sartajChowdhury/EECS452MDE/README.txt

TEAM MEMBERS:
Adam Karaien - akaraien@umich.edu	
Jesse Hu - jessehu@umich.edu
Megi Shahollari - mshaholl@umich.edu
Ross Richards - rossrish@umich.edu
Sartaj Chowdhury - sartajc@umich.edu

ZIP FILE CONTENTS:
video folder (contains demo footage)
src folder (contains OVERVIEW.txt, USAGE.txt)
design folder (contains part list)
data folder (contains plots)
README.txt
COPYRIGHT.txt
2024-Team-7-poster.pdf
2024-Team-7-final.pdf
