sartajChowdhury/EECS452MDE/2024-Team-7-poster.pdf

# Mobile ECG Measurement

Sartaj Chowdhury, Jesse Hu, Adam Karaien, Ross Richards, Megi Shahollari {sartajc, jessehu, akaraien, rossrich, mshaholl}@umich.edu

## EECS 452 - Winter 2024 Digital Signal Processing

## Introduction: Collecting Heart Rate Signal From Electrodes

## Signal Processing Techniques: Removing Noise From ECG Signal

- Electrocardiogram (ECG) is a recording of electrical activity from the heart
- Three sets of electrode leads capture ECG signals
- ECG signals require processing to extract useful information from them

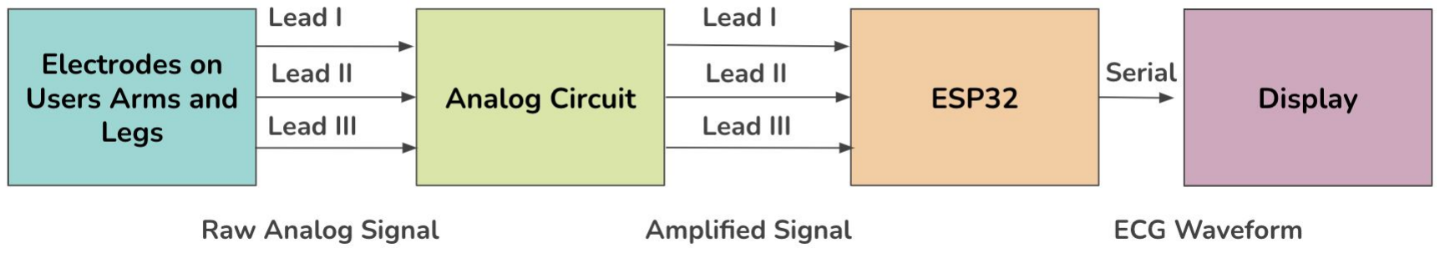
[picture p4: figure]

## Implementation: 3-Lead ECG with Analog Circuit and ESP-32

•Remove Baseline Wander:

- 0.5-150 Hz Bandpass Filter •Software Filter:
- 60 Hz Notch Filter
- Peak Detection:
- Pan-Tompkins Algorithm
- Real-time Plotting:
- Serial Communication -> Python Script

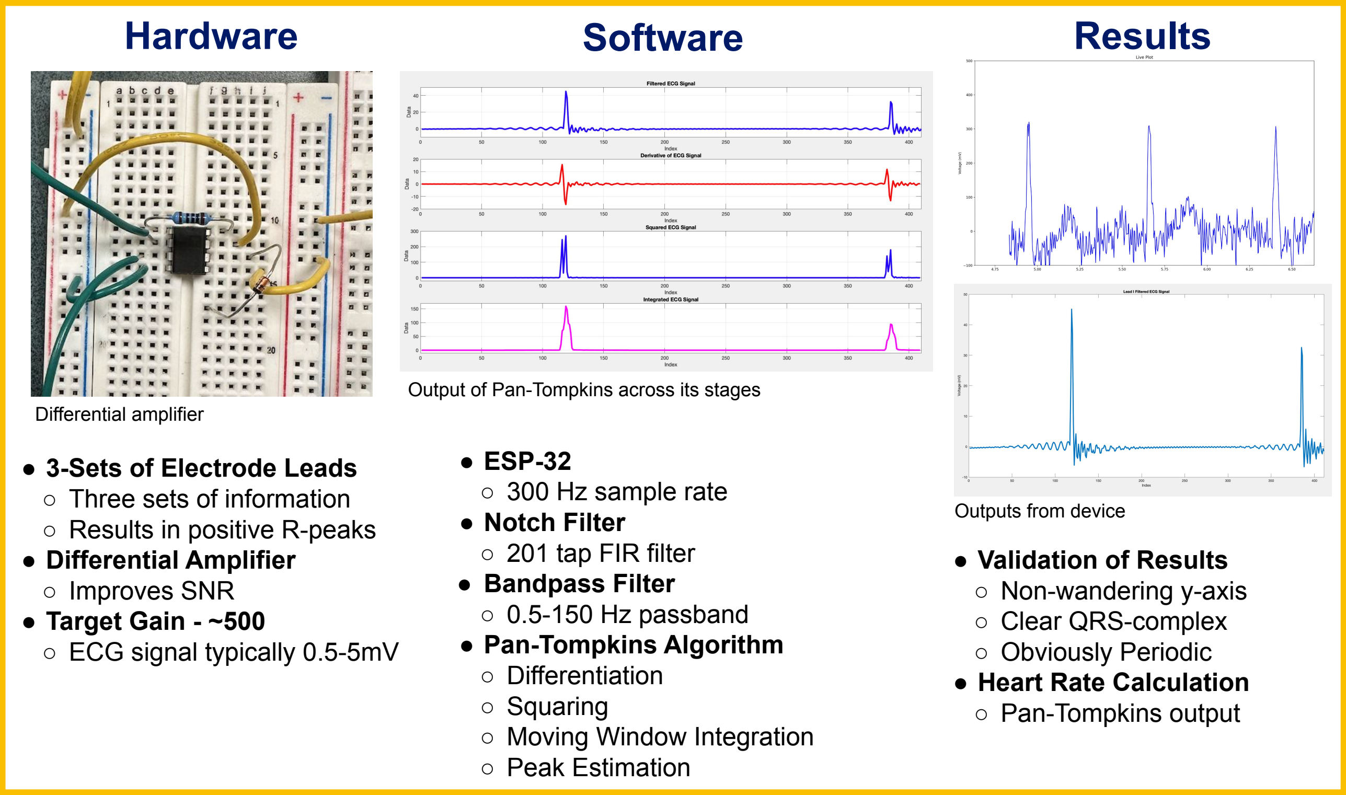
[picture p5: figure]
Hardware; Software; ● Validation of Results ○ Non-wandering y-axis ○ Clear QRS-complex ○ Obviously Periodic ● Heart Rate Calculation ○ Pan-Tompkins output; ● ESP-32 ○ 300 Hz sample rate ● Notch Filter ○ 201 tap FIR filter ● Bandpass Filter ○ 0.5-150 Hz passband ● Pan-Tompkins Algorithm ○ Differentiation ○ Squaring ○ Moving Window Integration ○ Peak Estimation; ● 3-Sets of Electrode Leads ○ Three sets of information ○ Results in positive R-peaks ● Differential Amplifier ○ Improves SNR ● Target Gain - ~500 ○ ECG signal typically 0.5-5mV; Results; Differential amplifier; Outputs from device

Acknowledgements: Special thanks to Dr. Shai Revzen and Audrey Cooke

Output of Pan-Tompkins across its stages
