sartajChowdhury/EECS452MDE/data/bodeBP.png

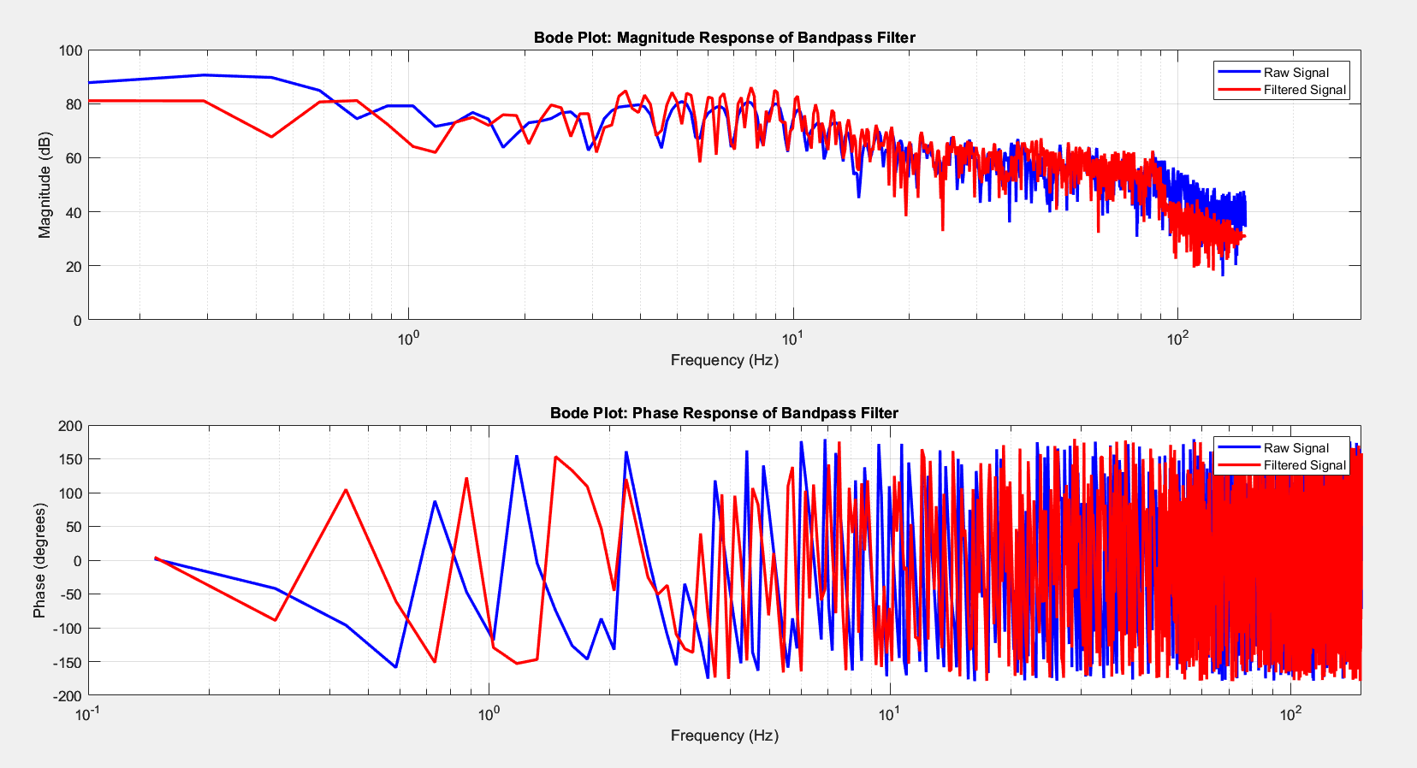
data/bodeBP.png
