sartajChowdhury/EECS452MDE/data/FIR_Notch_Filter_Bode_Plot.png

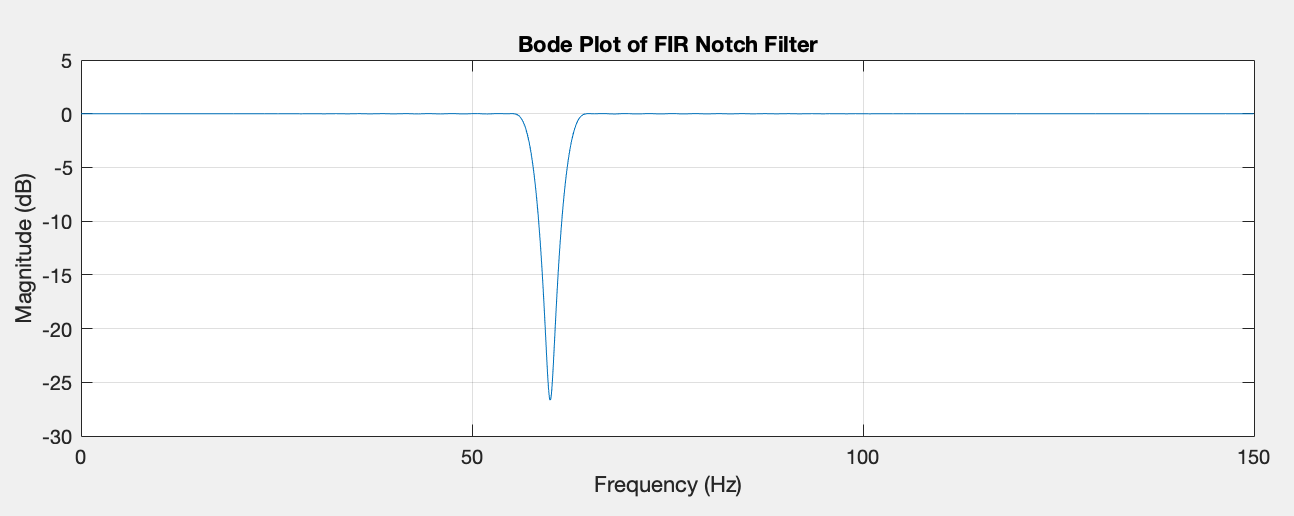
data/FIR_Notch_Filter_Bode_Plot.png
