sartajChowdhury/EECS452MDE/design/Parts_List.pdf

### EECS 452 Group

### 7 Parts List

P a r t N u m b e r | D e s c r i p t i o n | O r d e r i n g U R L | Q t y | P r i c e
B 0 8 2 P 9 N L 5 9 | 4 0 P a c k o f E l e c t r o d e s | h t t p s:// w w w.a m a z o n.c o m / K S -P r e miu m -Ele c t r o d e -R e u s a ble -Ele c t r o d e s / d p / B 0 8 2 P 9 N L 5 9 / r e f = s r_ 1 _ 1 ? c rid = 3 G 5 O F L 4 T W N 4 Z N & k e y w o r d s = ele c t r o d e & qid = 1 7 0 7 4 4 1 5 3 3 & s p r e fix = el (https://www.amazon.com/KS-Premium-Electrode-Reusable-Electrodes/dp/B082P9NL59) ectrode%2Caps%2C257&sr= 8-1 | 1 | $ 1 6.9 9
2 0 5 0 | L C D S c r e e n | h t t p s:// w w w.a d a f r uit.c o m / p r o d u c t / 2 0 5 0 ? g a d _ s o u r c e = 1 & g cli (https://www.adafruit.com/product/2050?gad_source=1) d=EAIaIQobChMI0aWKy93Z hAMVV19HAR2D8g_3EAQY BiABEgJvAfD_BwE | 1 | $ 3 9.9 5
E L -C K -0 0 4 | R e s i s t o r K i t | h t t p s:// w w w.a m a z o n.c o m / Ele g o o -Valu e s -R e sis t o r -A s s o r t m e n t -C o m plia n t / d p / B 0 7 2 B L 2 V X 1 / r e f = s r_ 1 _ 2 _ s s p a ? c rid = 1 L 6 8 N B G O 8 W 0 V M & k e y w o r d s = r e sis t o r + kit & qid = 1 7 0 7 4 4 1 7 2 9 & s p r e fix = r e sis t o r + kit % 2 C a p s % 2 C 1 2 2 & s r = 8 -2 -s p o n s & s p _ c s d = d 2lk Z 2 V 0 T m F t Z T 1 z c F 9 h d G Y & p s c = 1 (https://www.amazon.com/Elegoo-Values-Resistor-Assortment-Compliant/dp/B072BL2VX1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) | 1 | $ 7.9 9
B 0 C 1 V 8 Q 9 3 P | C ap a c i t o r K i t | h t t p s:// w w w.a m a z o n.c o m /A L L E CIN -M o n olit hic -C e r a mic -C a p a cit o r -Kit / d p / B 0 C 1 V 8 Q 9 3 P / r e f = s r_ 1 _ 2 _ s s p a ? c rid = 3 4 1 X Y S 8 T J 8 Q 8 2 & k e y w o r d s = c a p a ci (https://www.amazon.com/ALLECIN-Monolithic-Ceramic-Capacitor-Kit/dp/B0C1V8Q93P?sp_csd=d2lkZ2V0TmFtZT1zcF9hdGY) tor+kit&qid=1707441923&spr efix=capacitor+kit%2Caps%2 C124&sr=8-2-spons&sp_csd =d2lkZ2V0TmFtZT1zcF9hdG Y&psc=1 | 1 | $ 9.9 9
E L -C P -0 0 3 | B r e a d B o a r d | h t t p s:// w w w.a m a z o n.c o m / E L -C P -0 0 3 -B r e a d b o a r d -S old e rle (https://www.amazon.com/EL-CP-003-Breadboard-Solderless-Distribution-Connecting/dp/B01EV6LJ7G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) | 1 | $ 9.9 9

| | s s -Dis t rib u tio n -C o n n e c tin g / d p / B 0 1 E V 6 L J 7 G / r e f = s r_ 1 _ 1 _ s s p a ? c rid = 2 3 P G E T J H GI3 6 4 & k e y w o r d s = b r e a d b o a r d & qid = 1 7 0 7 4 4 1 5 7 4 & s p r e fix = b r e a d b o a r d % 2 C a p s % 2 C 1 3 8 & s r = 8 -1 -s p o n s & s p _ c s d = d 2lk Z 2 V 0 T m F t Z T 1 z c F 9 h d G Y & t h = 1 (https://www.amazon.com/EL-CP-003-Breadboard-Solderless-Distribution-Connecting/dp/B01EV6LJ7G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)
1 1 5 1 7 4 | I n s t ru m e n t a t i o n A m p A D 6 2 0 | h t t p s:// w w w.j a m e c o.c o m / z /A D 6 2 0 A N -A n alo g -D e vic e s -IC -A D 6 2 0 A N -L o w -C o s t -L o w -P o w e r -In s t r u m e n t -A m p -1 8 V-6 5 0 m W_ 1 1 5 1 7 4.h t ml? CID = G O O G & g a d _ s o u r c e = 4 & g clid = Cj w K C AiAlc y u B h B n Eiw A O G Z 2 S 7 c g d HiL B U a 5 N N a 1 8 d s A b M L 1 U Q A f 3 miW x 3 P g -glD 4 Y 9 m Z AA W J v_ 2 b h o C Z S M Q Av D _ B w E (https://www.analog.com/en/products/ad620.html) | 8 | $ 1 5.0 0
5 9 5 -U A 7 4 1 C P | O p -A m p | h t t p s:// w w w.m o u s e r.c o m / P r o d u c t D e t ail/ Te x a s -In s t r u m e n t s / U A 7 4 1 C P ? q s = W z g T T 8 0 q u P H F 8 v T 6 3 U V w 5 w % 3 D % 3 D & m g h = 1 & g a d _ s o u r c e = 4 & g clid = Cj w K C AiAlJ K u B h A d Eiw A n Z b 7lT f N r k_ G 9 o 3lQ -p c Z 5 z o S S g 5lX C 5 E q G 5 O kl9 r 9 a 6Iu 6 p D s t 3 d Z z h G x o C 6 b 8 Q Av D _ B w E (https://www.mouser.com/ProductDetail/Texas-Instruments/UA741CP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) | 4 | $ 0.4 9
A D 8 2 3 2 A C P Z -R 7 | E C G B a c kup C h i p | h t t p s:// w w w.digik e y.c o m / e n / p -i (https://www.digikey.com/en/products/detail/analog-devices-inc./AD8232ACPZ-R7/3758424?gad_source=1) nc./AD8232ACPZ-R7/375842 4?utm_adgroup=&utm_sourc e=google&utm_medium=cpc &utm_campaign=PMax%20S hopping_Product_Medium%2 0ROAS%20Categories&utm_ term=&utm_content=&utm_id =go_cmp-20223376311_adg- _ad-__dev-c_ext-_prd-37584 24_sig-Cj0KCQiA5rGuBhCnA RIsAN11vgTm-kWJWhaUuNii r o d u c t s / d e t ail/ a n alo g -d e vic e s | 6 | $ 4.9 2

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
cli (https://www.digikey.com/en/products/detail/analog-devices-inc./AD8232ACPZ-R7/3758424?gad_source=1) d=Cj0KCQiA5rGuBhCnARIsA N11vgTm-kWJWhaUuNii0siN cOK5R8JXtnGkUC3xqinzz7p puulXdSISAdAaAp-gEALw_w cB

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
s://

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
w (https://www.amazon.com/LAMPVPATH-Battery-Holder-Switch-Leads/dp/B07L9M6VZK?hvadid=309750549985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) itch-Leads/dp/B07L9M6VZK/r ef=asc_df_B07L9M6VZK/?ta g=hyprod-20&linkCode=df0& hvadid=309750549985&hvpo s=&hvnetw=g&hvrand=50603 30220317387031&hvpone=& hvptwo=&hvqmt=&hvdev=c& hvdvcmdl=&hvlocint=&hvlocp hy=9016855&hvtargid=pla-84 0154936712&psc=1&mcid=4 677ab6b39943642b3e5b8eb 4c05edd7&gclid=Cj0KCQjwzt OwBhD7ARIsAPDKnkCoWI0 bte8S_COFVmJzlfZ3yoGWO GZhQnTcOLE4nQtFhUSbYeb h1S4aAsY-EALw_wcB

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
